WPIRoboticsEngineering/1001-romi-processor-shim/README.md

# 1001-romi-processor-shim
A small adapter PCB that simplifies the wiring between the ROMI motor driver board and a esp32 dev module.
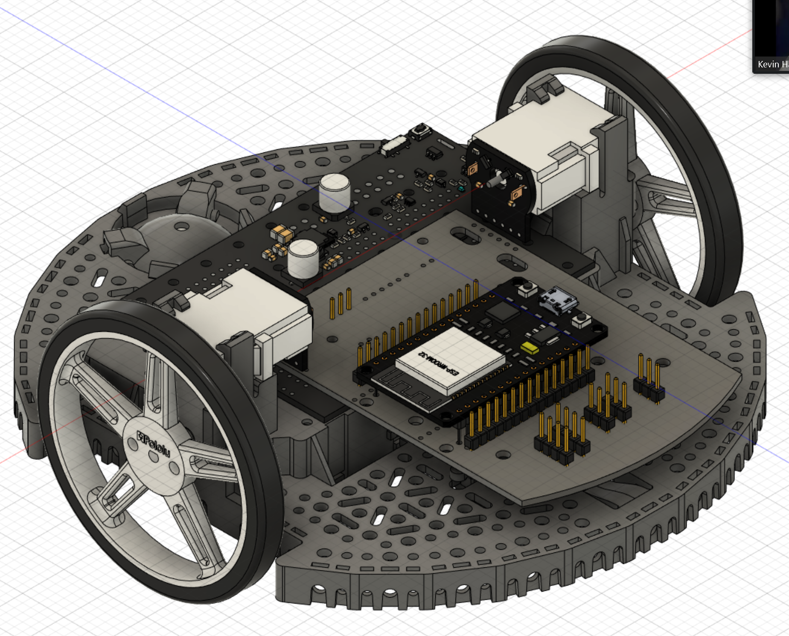
[picture p1: romi-top-right.png]
board
