WPIRoboticsEngineering/1001-romi-processor-shim/pcb.png

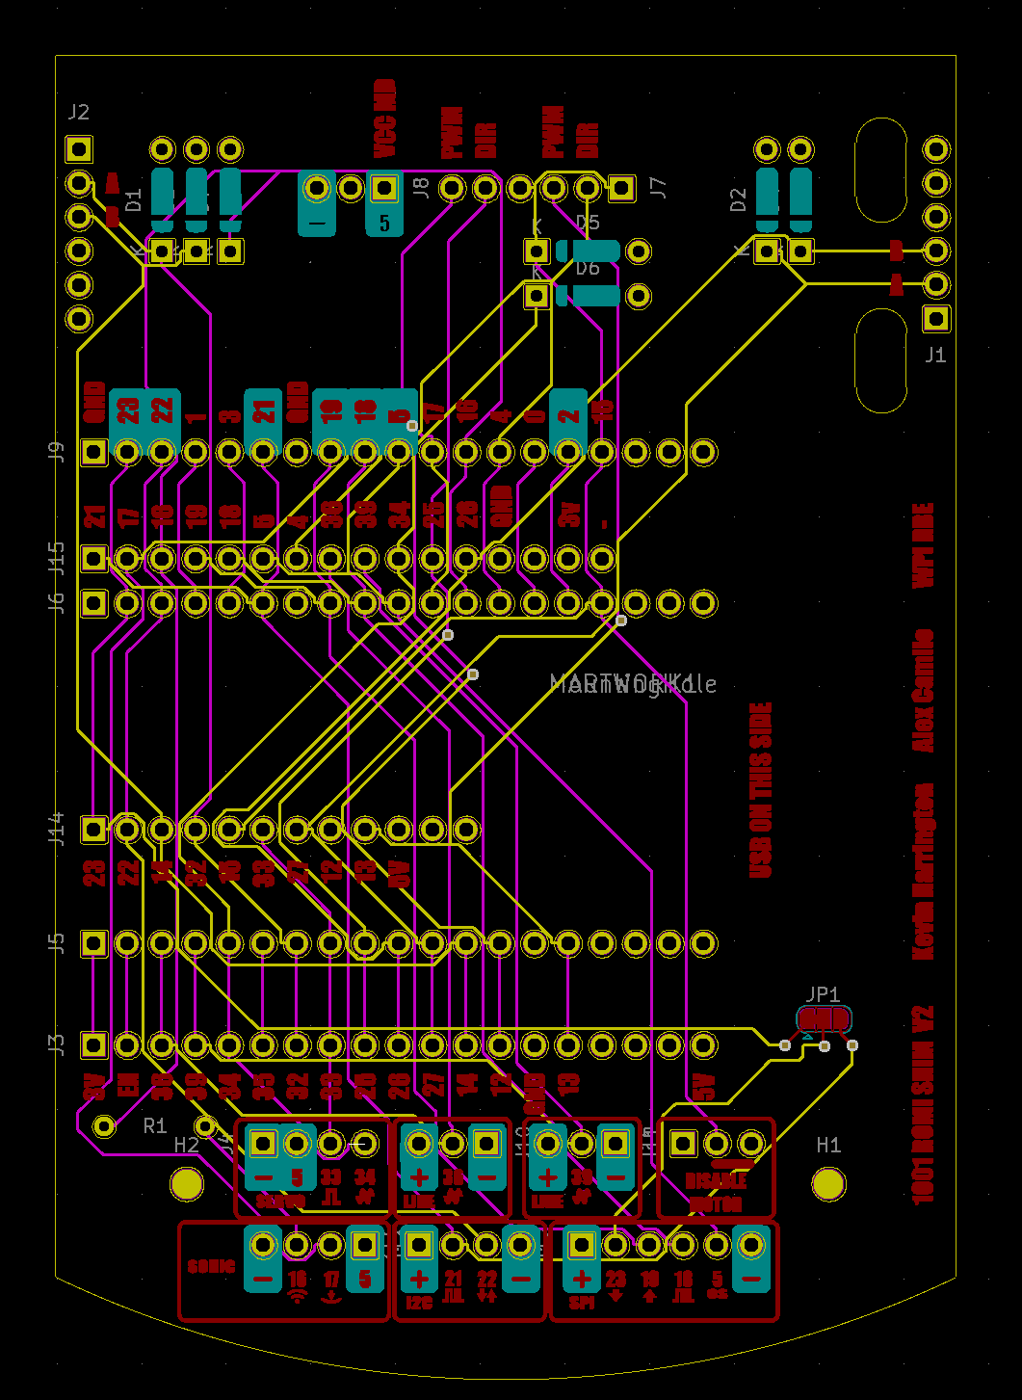
pcb.png
