WPIRoboticsEngineering/1001-romi-processor-shim/board-outline-with-holes.dxf

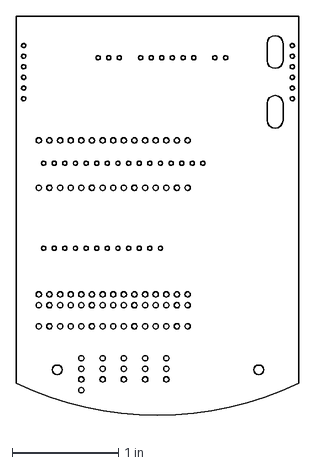
[picture p3: CAD file, 2020-06-17]
board-outline-with-holes.dxf
2.66 x 3.86 in
