WPIRoboticsEngineering/1001-romi-processor-shim/shim-PCB/shim-PCB.kicad_pcb

## KiCad design shim-PCB/shim-PCB.kicad_pcb (2020-08-10)

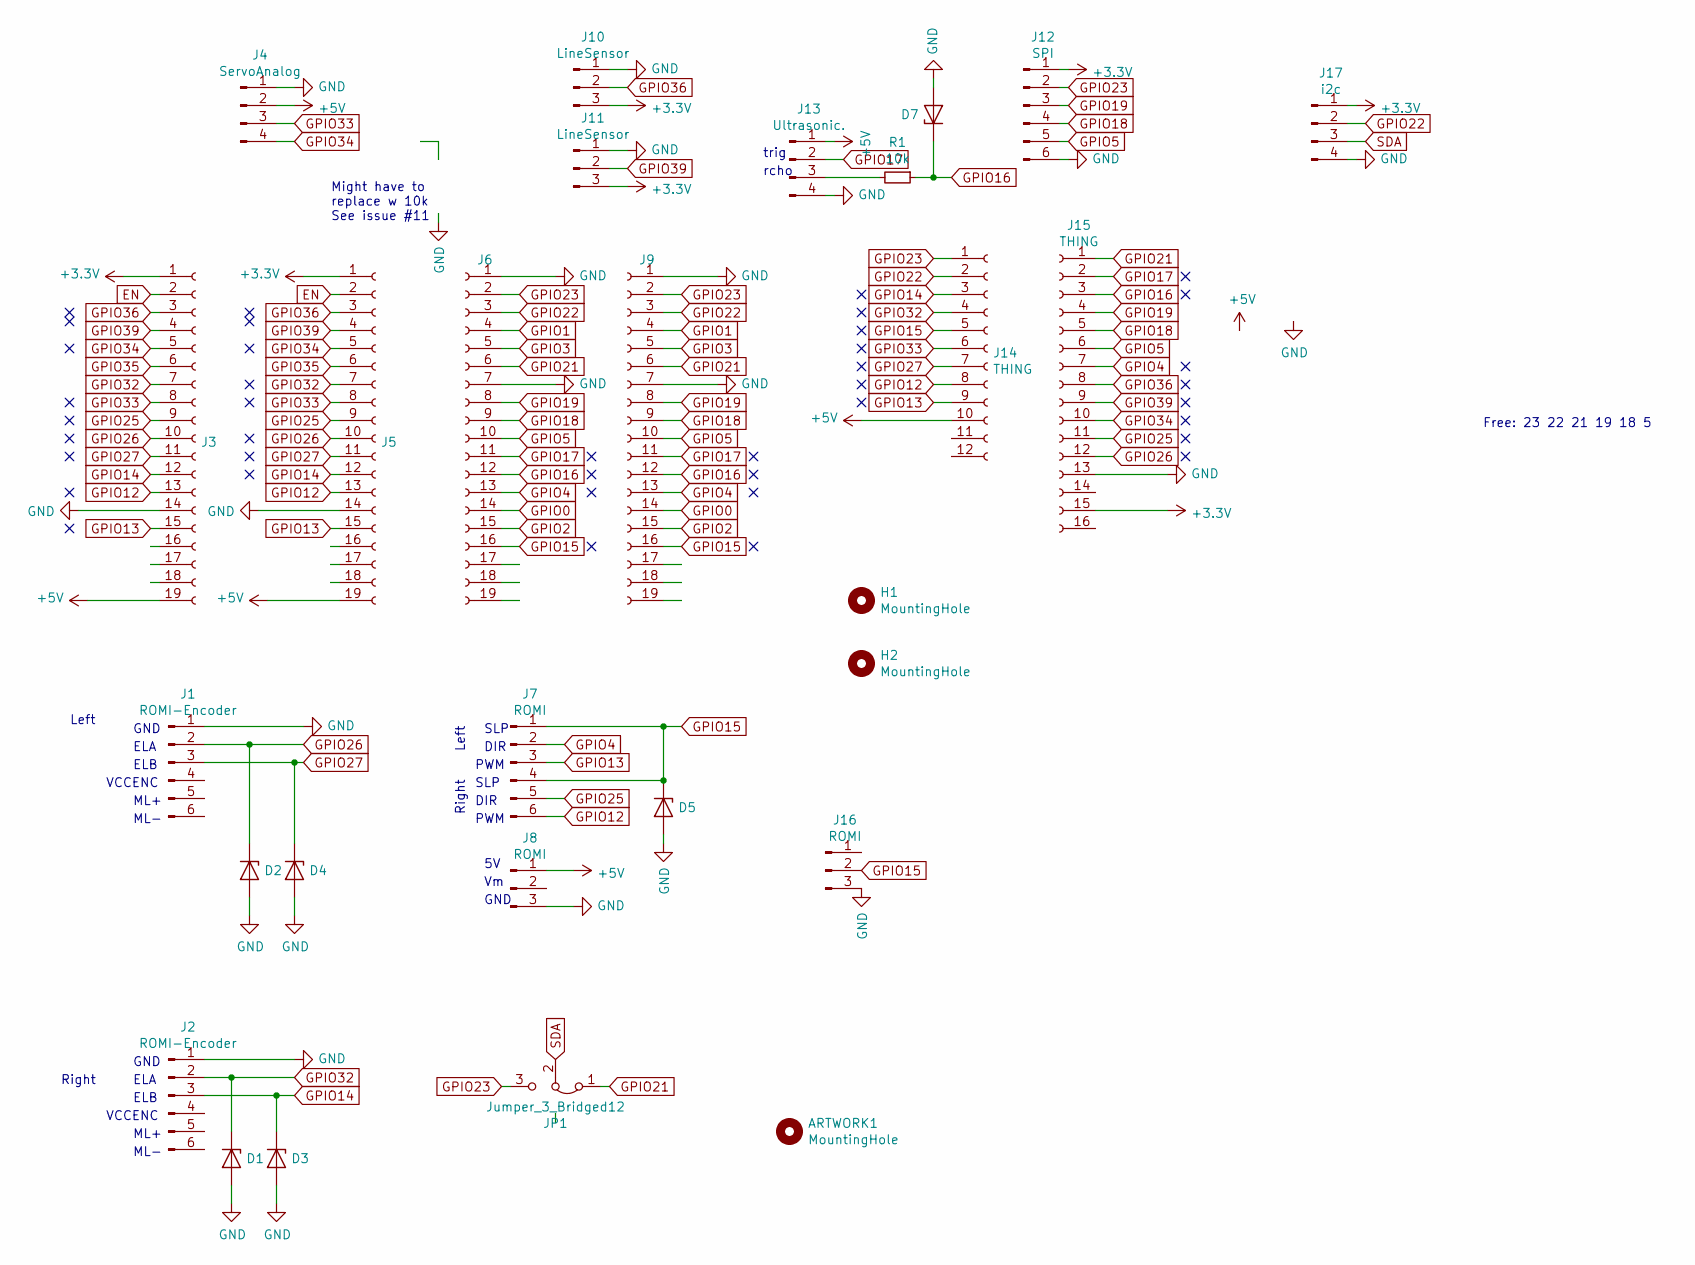
[picture p4: schematic shim-PCB.sch]

Parts:
ARTWORK1: MountingHole; silkscreen
D1, D2, D3, D4, D5, D7: D_Zener; D_DO-35_SOD27_P7.62mm_Horizontal
H1, H2: MountingHole; MountingHole_2.2mm_M2_DIN965
J1, J2: ROMI-Encoder; PinSocket_1x06_P2.54mm_Vertical
J3, J5, J6, J9: Conn_01x19_Female; PinSocket_1x19_P2.54mm_Vertical
J4: ServoAnalog; PinSocket_1x04_P2.54mm_Vertical
J7: ROMI; PinSocket_1x06_P2.54mm_Vertical
J8, J16: ROMI; PinSocket_1x03_P2.54mm_Vertical
J10, J11: LineSensor; PinSocket_1x03_P2.54mm_Vertical
J12: SPI; PinSocket_1x06_P2.54mm_Vertical
J13: Ultrasonic.; PinSocket_1x04_P2.54mm_Vertical
J14: THING; PinSocket_1x12_P2.54mm_Vertical
J15: THING; PinSocket_1x16_P2.54mm_Vertical
J17: i2c; PinSocket_1x04_P2.54mm_Vertical
JP1: Jumper_3_Bridged12; SolderJumper-3_P1.3mm_Bridged12_RoundedPad1.0x1.5mm
R1: 10k; R_Axial_DIN0204_L3.6mm_D1.6mm_P7.62mm_Horizontal

Connections:
+3V3: J3.1, J5.1, J10.3, J11.3, J12.1, J15.15, J17.1
+5V: J3.19, J4.2, J5.19, J8.1, J13.1, J14.10
EN: J3.2, J5.2
GND: D1.2 (A), D2.2 (A), D3.2 (A), D4.2 (A), D5.2 (A), D7.2 (A), J1.1, J2.1, J3.14, J4.1, J5.14, J6.1, J6.7, J8.3, J9.1, J9.7, J10.1, J11.1, J12.6, J13.4, J15.13, J16.3, J17.4
GPIO0: J6.14, J9.14
GPIO1: J6.4, J9.4
GPIO2: J6.15, J9.15
GPIO3: J6.5, J9.5
GPIO4: J6.13, J7.2, J9.13, J15.7
GPIO5: J6.10, J9.10, J12.5, J15.6
GPIO12: J3.13, J5.13, J7.6, J14.8
GPIO13: J3.15, J5.15, J7.3, J14.9
GPIO14: D3.1 (K), J2.3, J3.12, J5.12, J14.3
GPIO15: D5.1 (K), J6.16, J7.1, J7.4, J9.16, J14.5, J16.2
GPIO16: D7.1 (K), J6.12, J9.12, J15.3, R1.1
GPIO17: J6.11, J9.11, J13.2, J15.2
GPIO18: J6.9, J9.9, J12.4, J15.5
GPIO19: J6.8, J9.8, J12.3, J15.4
GPIO21: J6.6, J9.6, J15.1, JP1.1 (A)
GPIO22: J6.3, J9.3, J14.2, J17.2
GPIO23: J6.2, J9.2, J12.2, J14.1, JP1.3 (B)
GPIO25: J3.9, J5.9, J7.5, J15.11
GPIO26: D2.1 (K), J1.2, J3.10, J5.10, J15.12
GPIO27: D4.1 (K), J1.3, J3.11, J5.11, J14.7
GPIO32: D1.1 (K), J2.2, J3.7, J5.7, J14.4
GPIO33: J3.8, J4.3, J5.8, J14.6
GPIO34: J3.5, J4.4, J5.5, J15.10
GPIO35: J3.6, J5.6
GPIO36: J3.3, J5.3, J10.2, J15.8
GPIO39: J3.4, J5.4, J11.2, J15.9
unnamed: J13.3, R1.2
SDA: J17.3, JP1.2 (C)

Notes on the sheet:
SLP
DIR
PWM
GND
ELA
ELB
VCCENC
ML+
ML-
trig
rcho
Might have to replace w 10k See issue #11
Right
Left
Free: 23 22 21 19 18 5

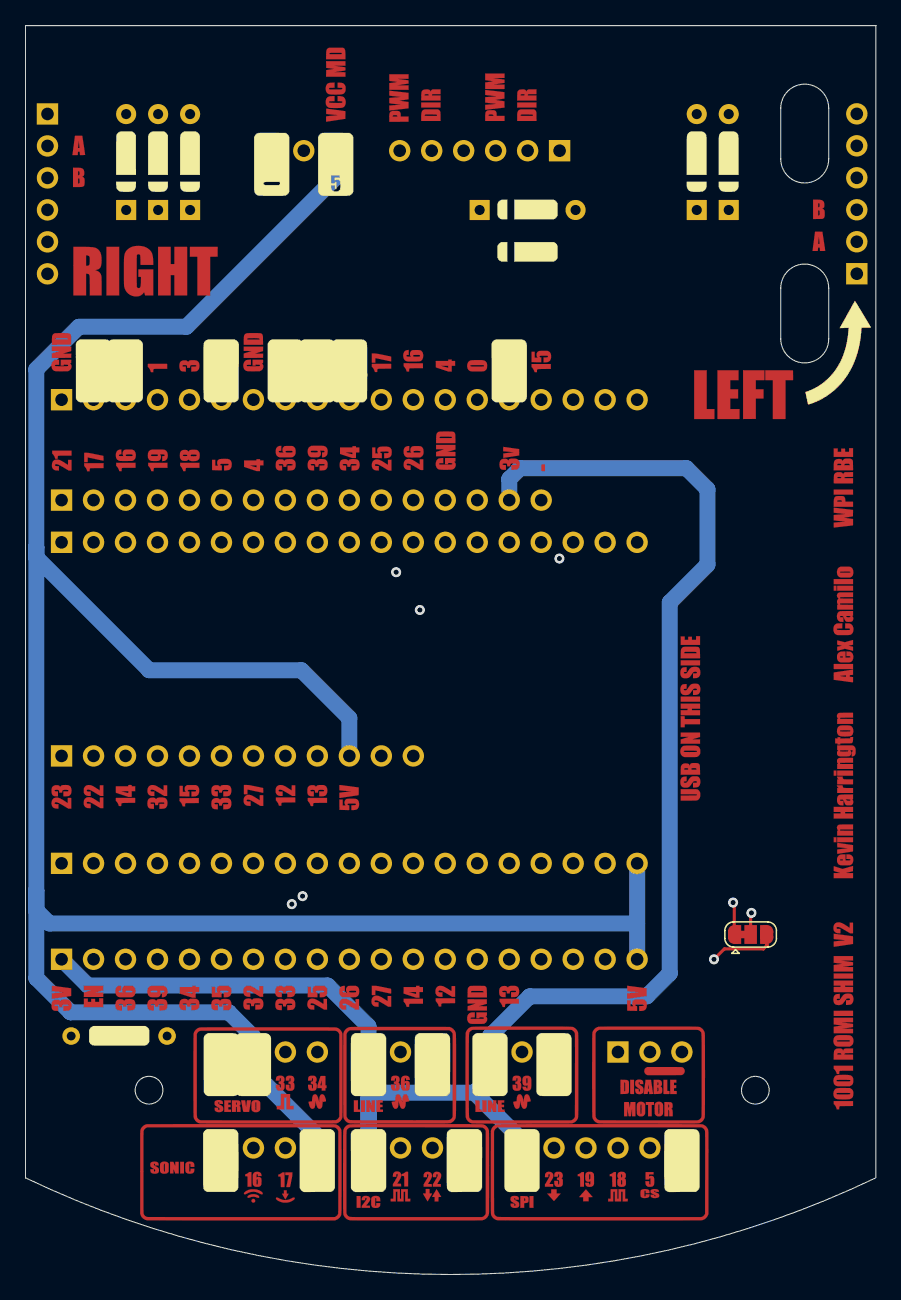
[picture p5: board shim-PCB.kicad_pcb from above]

Board: 4 copper layers, 67.5 x 99.2 mm, 28 parts (0 on the bottom side), 32 nets.
