WPIRoboticsEngineering/1001-romi-processor-shim/(threads)

Thread 1 (2020-06-18):

Footprint for Devkitc v4 needed

madhephaestus, 2020-06-18:
https://docs.espressif.com/projects/esp-idf/en/latest/esp32/hw-reference/esp32/get-started-devkitc.html

madhephaestus, 2020-06-18:
if this was added, close it with this issue number in the commit

Closed 2020-06-18.

Thread 11 (2020-06-18):

Clamp the analog signal coming back from the servo to 3.3v

madhephaestus, 2020-06-18:
We do not know what the voltage range is exactly, but we know we need to clamp it to 3.3v.

acamilo, 2020-06-18:
There might be a problem here. If this is the wiper of the pot then putting a zener on it could clamp it and prevent the voltage from going above 3.3v and keep the servo from making it's full range of motion.

If the servo is turned all the way over this can short the 5v rail through the pot causing damage. I recommend replacing this with a high value resistor like a 10k and letting the input pin clamp it to vcc.  I'm putting a schematic symbol for a zener but we can swap it out on the BOM with a resistor.

madhephaestus, 2020-06-18:
so a 10k in-line? that could work. Is there a pull-up on that pin on the board?

acamilo, 2020-06-18:
no, it goes right from a pin out to the servo's pot.

Closed 2020-06-18.

Thread 12 (2020-06-18):

Hard-wire romi driver board pins to the ESP

madhephaestus, 2020-06-18:
Left PWM to GPIO 13
Left DIR to GPIO 4/ A5
Right PWM to GPIO 12
Right DIR to GPIO 25/A1
ELA to GPIO 27
ELB to GPIO 26/A0
ERA to GPIO 17/TX1
ERB to GPIO 16/RX1
VCC MD to VUSB
GND to GND on the Esp32

acamilo, 2020-06-18:
VPU to 3.3 is not needed because we're not cutting the trace on the Romi Driver and instead using clamping diodes on the shim.

acamilo, 2020-06-18:
Define "Left and Right"

madhephaestus, 2020-06-18:
those are the labels on the PCB

acamilo, 2020-06-18:
ok thanks

Closed 2020-06-18.

Thread 13 (2020-06-18):

CLamp the ~SLP line coming off the drivers

madhephaestus, 2020-06-18:
The digital line coming of the ~slp pin on the drivers should be clamped to 3.3v

This pin should be brought out to a 2x1 female header of ~SLP(CLamped)/ GND

madhephaestus, 2020-06-18:
cool! issue/commit linking working

Closed 2020-06-18.

Thread 14 (2020-06-18):

Review pin-out and header placement of shim

acamilo, 2020-06-18:

madhephaestus, 2020-06-18:
Spread the user headers out a lot more to make room for SS, move the serial bus's off to the right into that free space

madhephaestus, 2020-06-18:
in fact, move all the headers to the space near the DevKitC's antenna, leaving lots of space for the devkitC heared labels

madhephaestus, 2020-06-18:
Pinout confirmed.

acamilo, 2020-06-18:
The USB comes in from the left and the antenna hangs over the side on the right.

acamilo, 2020-06-18:
i'm going to slide both modules over to the right and put the headers on the left. Sound good?

madhephaestus, 2020-06-18:
then they will interfere with the USB

acamilo, 2020-06-19:
The cables enter in through the right.

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

acamilo, 2020-06-19:
I think we have enough room for the labels as it is. I don't think moving the modules is a good idea.
I can move the headers a little.

acamilo, 2020-06-19:
Look at these labels. That's what i had in mind.
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

acamilo, 2020-06-19:
Also, The thing plus
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

acamilo, 2020-06-19:
Check out the board, I moved stuff around to free up some room.

madhephaestus, 2020-06-19:
looks good

acamilo, 2020-06-19:
Awesome

Closed 2020-06-19.

Thread 6 (2020-06-18):

A row of labled headers to mirror the DevKitC v4

madhephaestus, 2020-06-18:
headers should be 19x1 female
GPIO lables on all pins

A second label with its use as it has been hard-wired by the shim

acamilo, 2020-06-18:
Schematic reflects this.

Closed 2020-06-19.

Thread 9 (2020-06-18):

Pinout

madhephaestus, 2020-06-18:
// Pins used by a perpheral, may be re-used
#define BOOT_FLAG_PIN 			0
#define I2C_SDA       			21
#define I2C_SCL       			22
#define SERIAL_PROGRAMMING_TX 	1
#define SERIAL_PROGRAMMING_RX 	3

#define SPI_MOSI 23
#define SPI_MISO 19
#define SPI_SCK  18
#define SPI_SS   5

// Ultrasonics
#define SIDE_ULTRASONIC_TRIG 32
#define SIDE_ULTRASONIC_ECHO 14

//A4
#define LEFT_LINE_SENSE 36
//A3
#define RIGHT_LINE_SENSE 39

#define SERVO_FEEDBACK_SENSOR		34
/**
 * Gripper pin for Servo
 */
#define SERVO_PIN 33

#define MOTOR_DISABLE 15

/**
 * Drive motor 1 10Khz full duty PWM pin
 */
#define MOTOR1_PWM 13
/**
 * Pin for setting the direction of the H-Bridge
 */
//A5
#define MOTOR1_DIR 4
/**
 * Drive motor 2 10Khz full duty PWM pin
 */
#define MOTOR2_PWM 12
/**
 * Pin for setting the direction of the H-Bridge
 */
//A1
#define MOTOR2_DIR 25
//Encoder pins

#define MOTOR1_ENCA 27
//A0
#define MOTOR1_ENCB 26

#define MOTOR2_ENCA 17
#define MOTOR2_ENCB 16

madhephaestus, 2020-06-18:
If the pinout changes, the latest will be added as a comment

acamilo, 2020-06-18:
5 or 15. please confirm.

acamilo, 2020-06-18:
CS on 5 or 15, Please confirm.

madhephaestus, 2020-06-18:
VSPI slave select is GPOI 5

acamilo, 2020-06-18:
ok. cool.

Closed 2020-06-18.

Thread 16 (2020-06-19):

Label convention for special function headers

madhephaestus, 2020-06-19:
Each pin should be labeled with its GPIO number, and its function.

IE
```
VSPI_SCK/5
```

and

```
ECHO/14
```

Around typed headers, make a SS box with a label (like the 3001 motherboard had).

```
VSPI
HC-SR04
Line Sense L
Line Sense R
I2C
Servo
```

acamilo, 2020-06-19:
Can we entertain a more compact label configuration?

acamilo, 2020-06-19:
Perhaps, having the sensor headers labeled with the function (ultrasonic, spi, linefollowing)
Then, put the GPIO number (the one used in code) next to each pin.

And then, have a key or a note, to the side with a pin-out of the sensor.

acamilo, 2020-06-19:
One exception, the headers for a BUS (SPI,I2C) will be labed with the bus signal (SI,SO,SDA,SCL, ..etc)

acamilo, 2020-06-19:
Let me put together a draft for us to review.

acamilo, 2020-06-19:
Adafruit places the pin name next to the sensor.
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

acamilo, 2020-06-19:
What about something like this? This is for the ultrasonic.
* Polarity is indicated with - and+
* Trigger and Echo indicated with icons
* GPIO Pins Labeled
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

acamilo, 2020-06-20:
What about something like this?
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

acamilo, 2020-06-20:
I might want to pick a different font for the text. it is a little cramped.
Maybe we ditch the icons and just do GPIO numbers and labels?

acamilo, 2020-06-20:
For the other headers, How about something like this?
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

madhephaestus, 2020-06-20:
awesome!

On Fri, Jun 19, 2020 at 9:40 PM Alex Camilo <notifications@github.com>
wrote:

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

madhephaestus, 2020-06-29:
There is no way for the user to see what pins are "availible". A SS label of how each pin is used, highlighting pins that are hard-routed and so not availible.

acamilo, 2020-07-10:
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

Closed 2020-07-10.

Thread 18 (2020-06-29):

[rev 1] the footprint for DevKitC is too wide

madhephaestus, 2020-06-29:
it is 0.1inch too wide and the module does not fit.

Closed 2020-07-09.

Thread 21 (2020-06-29):

Rotate the ultrasonic 180 deg

madhephaestus, 2020-06-29:
If you stick the hc-sr04 into the socket on the board, it faces into the robot, but would be useful if it faced forward.

if forward is down, from left to right:
+,14,32,-

Closed 2020-07-09.

Thread 22 (2020-07-03):

+5 ss label on the 3 pin header from the romi board is wrong

madhephaestus, 2020-07-03:
The label is on the gnd pin. the pin is wired correctly, but the the label is wrong.

Closed 2020-07-09.

Thread 23 (2020-07-04):

+5 and gnd label on ultrasonic/spi/i2c wrong

madhephaestus, 2020-07-04:
all the power labels on the bottom row are wrong

Closed 2020-07-09.

Thread 25 (2020-07-11):

Swap 16/17 on the encoder lines with the ultrasonic Echo/Trig

madhephaestus, 2020-07-11:
These pins are special function pins on the SAMD51 feather and it would be valuable to have them free in the shim to use the samd51 in the future.

Thread 26 (2020-07-15):

SPI chip select conflicts with I2C

gcl8a, 2020-07-15:
On the schematic that Kevin sent me -- which I think is this version -- the SPI breakout pins include GPIO23, but that pin is part of the I2C bus on the Feather. You might want to use GPIO21.

acamilo, 2020-07-15:
I meant samd51, d'oh.

Closed 2020-07-15.

Thread 29 (2020-07-18):

The jumper for ~slp should be a selector to GPIO 15

madhephaestus, 2020-07-18:
On the shim PCB there is an additional protection diode on that pin so we can control it from a gpio, or jumper it to gnd. ~SLP is routed to the center pin in a male 3x1. To one side is ground (disable), and to the other side is GPIO15 with a protection diode.

Closed 2020-07-23.

Thread 30 (2020-07-20):

Change Ultrasonic to 5v

madhephaestus, 2020-07-20:
The voltage for the ultrasonic should be 5v

the echo pin needs an in line resistor, and a 3.3v clamp
the trig pin works at 3.3v

Closed 2020-07-23.

Thread 32 (2020-07-23):

Double check the dev kit C footprint

madhephaestus, 2020-07-23:
Use the footprint form the RIB, that one is tested correct. Check the pin spacing is correct

madhephaestus, 2020-07-23:
its 11 breadboard pins wide

acamilo, 2020-07-23:
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

Closed 2020-07-23.

Thread 33 (2020-07-23):

swap the SPI jumper for a trace cut style normlal connected

madhephaestus, 2020-07-23:

Closed 2020-07-23.

Thread 37 (2020-07-30):

Possibly move PWM pin

gcl8a, 2020-07-30:
If you swap the SERVO pin with M1_PWM, then it's marginally easier to control the PWM lines for both motors with the SAMD51. PA18 and PA19 default to the same TCC and TC, which would make timer (frequency) adjustment easier. You _can_ put PA17 and PA19 on the same TCC, but you have to do some magic to the Arduino libraries (e.g., edit variant.cpp for the board) or a little extra setup (hardly a big deal).

Not sure if swapping breaks anything on the ESP32, or even if it's worth it (there are plenty of TC/TCCs on the SAMD51), but if it's zero-loss elsewhere and only a #define change for the library, it might be worth it.

I haven't looked to see how the SAMD21 lines up. Happy to do that, if you want.

madhephaestus, 2020-08-10:
the esp has no hardware assigned pwm pins, so swapping is easy. the question i have is what eps pin is being pulled in here and where did it come from

madhephaestus, 2020-08-10:
could you rephrase this request as specific pin swaps you would like

madhephaestus, 2020-08-10:
we must deal with the fact that all pins are assigned. to move a pin, one must remove what was on it, and move it somewhere else. this is easy to do in the header, but just list off the specific swaps and i can test it.

gcl8a, 2020-08-10:
Let’s not worry about it for now. If we end up using a SAMD chip, we’ll have plenty of time to adjust — C-term at the earliest. I’m swamped today and it’s more important to get this out than to spend time testing something esoteric.

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

Closed 2020-08-10.

Thread 38 (2020-08-07):

[SILK SCREEN] Resistor for in-line ultrasonic is missing label

madhephaestus, 2020-08-07:

madhephaestus, 2020-08-10:
I would expect to see the symbol for resistor with the value

Closed 2020-08-10.

Thread 39 (2020-08-07):

Encoder lines on the motor that used to be backwards are now swapped

madhephaestus, 2020-08-07:
A and B are swapped. This can be worked around in the header, but now one motor counts up, while the other counts down going in the same direction. This should be fixed in hardware.

madhephaestus, 2020-08-08:
we will just fix this in sw for next term

madhephaestus, 2020-08-10:
Pin 26 and 27 should be swapped

madhephaestus, 2020-08-10:
26 -> elb
27->ela

Closed 2020-08-10.

Thread 40 (2020-08-09):

pin 22 connected to ECHO

gcl8a, 2020-08-09:
On my shim board, the ECHO pin is _directly_ connected to pin 22, in addition to pin 17 by way of the resistor.

ECHO
  |
  |-----------pin 22
  |
10k
  |
  |---------|zener---------GND
  |
pin 16

madhephaestus, 2020-08-10:
THis was a defect in this bioard run, the DRC check wasnt run after the last change and these lines were shorted at the fab.

ROuting has been fixed and a respin is planned for this afternoon.

acamilo, 2020-08-10:
fixed. Didn't run DRC after I added the resistor. Trace intersected pad.

Closed 2020-08-10.

Thread 41 (2020-08-09):

Odd behavior of jumper

gcl8a, 2020-08-09:
The left (default) pad is connected to pin 23, the middle to what is labelled MOSI, the right pin 21.

But SDA on the I2C is always connected to 21, so all switching the jumper does is connect MOSI to SDA.

I thought the goal was to switch the SDA pin between 21/23.

Also, the screen for the I2C has the pins reversed: SDA should be on 21 and SCL on 22.

It appears that it will all work with the DEV board, but not the default pins on a Feather. (Except for the problem with 22 connected to ECHO -- see issue #40 ).

acamilo, 2020-08-10:
misread request as SDO not SDA. Jumper now selects between 21/23 defaulting to 21

Closed 2020-08-10.

Thread 43 (2020-08-10):

[SILK SCREEN] Label Left and right, as they are labeled by the driver board

madhephaestus, 2020-08-10:
left and right as determined by the driver are opposite the orentation that the board was designed.

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

acamilo, 2020-08-10:
Changed labels in schematic

madhephaestus, 2020-08-10:
litteraly wanted silk screens to match the sharpie in the image

madhephaestus, 2020-08-10:
THIS IS A SILK SCREEN REQUEST

madhephaestus, 2020-08-10:
bigger, MUCH bigger

Closed 2020-08-10.
