WPIRoboticsEngineering/1001-romi-processor-shim/(commit log)

2020-06-12 Added image of board on bot.
2020-06-12 Added BOM CSV
    [romi-shim-bom-digikey.csv]
2020-06-16 Update BOM headers.
    Swapped out 15pin MALE headers with 15pin FEMALE headers for the debug headers.
    [romi-shim-bom-digikey.csv]
2020-06-16 Added headers for encoder pins
    [romi-shim-bom-digikey.csv]
2020-06-17 Board ready for review by kevin
    [board-outline-with-holes.dxf, shim-PCB.kicad_pcb, shim-PCB.sch]
2020-06-17 fixed bad trace
    [shim-PCB.kicad_pcb]
2020-06-18 Swapped out esp32 devkit for v4
    [shim-PCB.sch]
2020-06-18 Clamped ~SLP pin and added 02x01 header.
    Issue #13
    [shim-PCB.kicad_pcb, shim-PCB.sch]
2020-06-18 Clamped analog input signal.
    Fixed issue #11
    [shim-PCB.kicad_pcb, shim-PCB.sch]
2020-06-18 Swapped motor signals left-right
    ISsue #12
    [shim-PCB.sch]
2020-06-18 labeled left-rghtin schematic for motor signals
    [shim-PCB.kicad_pcb, shim-PCB.sch]
2020-06-18 Added left/right labels for encoders in schematic
    Issue #12
    [shim-PCB.sch]
2020-06-18 Changed VSPI SS to gpio5
    Issue #9
    [shim-PCB.sch]
2020-06-18 Broke out i2c
    ISsue #7
    [shim-PCB.kicad_pcb, shim-PCB.sch]
2020-06-19 Made more room for labels
    Issue #14
    [shim-PCB.kicad_pcb]
2020-06-19 routing power and ground
    [shim-PCB.kicad_pcb]
2020-06-19 Finished routing
    [shim-PCB.kicad_pcb]
2020-06-22 Working on silk
    [shim-PCB.kicad_pcb]
2020-06-22 Switched to 4 layer. Disconnected flash pins.
    Resolved #15
    [shim-PCB.kicad_pcb, shim-PCB.sch]
2020-06-23 Updated Silk and finished board.
    #16
    [shim-PCB.kicad_pcb]
2020-06-23 Added board label.
    [shim-PCB.kicad_pcb]
2020-07-06 swapped right encoder
    #24
    [shim-PCB.kicad_pcb]
2020-07-09 Moved gnd-slp jumper
    #19
    [shim-PCB.kicad_pcb]
2020-07-09 Rotate Ultrasonic 180 degrees
    #21
    [shim-PCB.kicad_pcb]
2020-07-09 made devkitc footprint shorter by 0.1"
    #18
    [shim-PCB.kicad_pcb]
2020-07-09 fixed silkscreen, routed board.
    #23 #22
    [shim-PCB.kicad_pcb]
2020-07-10 Added labels to free pins.
    [shim-PCB.kicad_pcb]
2020-07-15 Fixed silkscreen
    [shim-PCB.kicad_pcb, shim-PCB.sch]
2020-07-15 Updated Silkscreen
    [shim-PCB.kicad_pcb]
2020-07-15 new board rev
    Added jumper to switch between pins 21 and 23 to resolve conflict with samd21 i2c resolving issue #26
    Swapped encoder and ultrasonic pins to resolve conflict with samd21 resolving issue #25
    [shim-PCB.kicad_pcb, shim-PCB.sch]
2020-07-15 tied artwork to component
    [shim-PCB.kicad_pcb, shim-PCB.sch]
2020-07-15 changed visibility of layers, meeningless change.
    [shim-PCB.kicad_pcb]
2020-07-17 BOM for 2nd rev
    [shim-PCB.csv]
2020-07-23 Extended board, Added resistor.
    #30 #28
    [shim-PCB.kicad_pcb, shim-PCB.sch]
2020-07-23 ultrasonic to 5v
    #30
    [shim-PCB.kicad_pcb]
2020-07-23 3 pin jumper for motor disable
    #29
    [shim-PCB.kicad_pcb, shim-PCB.sch]
2020-07-23 Added diode, updated silkscreen. Sleep pin now 1x03
    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
    [shim-PCB.kicad_pcb, shim-PCB.sch]
2020-07-23 fixed silk on added resistor
    [shim-PCB.kicad_pcb]
2020-07-23 added label for motor shutoff
    [shim-PCB.kicad_pcb]
2020-07-23 gpio 23/21 select is now a jumper.
    #33
    [shim-PCB.kicad_pcb, shim-PCB.sch]
2020-07-23 Add note indicating wich side USB goes
    #36
    [shim-PCB.kicad_pcb]
2020-07-23 trace colision with pad
    [shim-PCB.kicad_pcb]
2020-07-23 Added 'free' label to pin2
    #35
    [shim-PCB.kicad_pcb]
2020-07-23 Update shim-PCB.kicad_pcb-bak
2020-08-10 fix drc error
    Resolves #40
    [shim-PCB-B_Cu.gbr, shim-PCB-B_Mask.gbr, shim-PCB-B_SilkS.gbr, shim-PCB-Edge_Cuts.gbr, shim-PCB-F_Cu.gbr, shim-PCB-F_Mask.gbr, shim-PCB-F_SilkS.gbr, shim-PCB-In1_Cu.gbr]
2020-08-10 Swapped 26/27
    #39
    [shim-PCB.kicad_pcb, shim-PCB.sch]
2020-08-10 Jumper switches SDA between 21/23 defaulting to 21
    resolved issue #41
    [shim-PCB.sch]
2020-08-10 swap SDA/SCL to match labels
    #41
    [shim-PCB.sch]
2020-08-10 fixed drc error
    [shim-PCB.kicad_pcb]
2020-08-10 Removed zener on servo position pin. swapped labels
    #42 closed #43 closed
    [shim-PCB.kicad_pcb, shim-PCB.sch]
2020-08-10 Added silk for resistor
    #38 closed
    [shim-PCB.kicad_pcb]
2020-08-10 Added left/right silkscreen labels
    #43 Closed
    [shim-PCB.kicad_pcb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]
2020-08-10 gompei silkscreen
2020-08-10 made labels much bigger
    #43
    [shim-PCB.kicad_pcb]
2020-08-10 added resistor value
    #38
    [shim-PCB.kicad_pcb]
